2qiao22/RM_Main_Board_Teensy4.1/README.md

# RM_NAGOYA_Main_Control_Board

## Overview
A main control board for robot control in the RoboMaster competition.

## Specifications
- **MCU**: Teensy 4.1  
- **IMU**: BNO055  
- **CAN**: 3 channels  
 
- **Design Tool**: KiCad 9.0
