2qiao22/RM_Main_Board_Teensy4.1/3D/B3B-XH-A-LF--SN---3DModel-STEP-418109.STEP

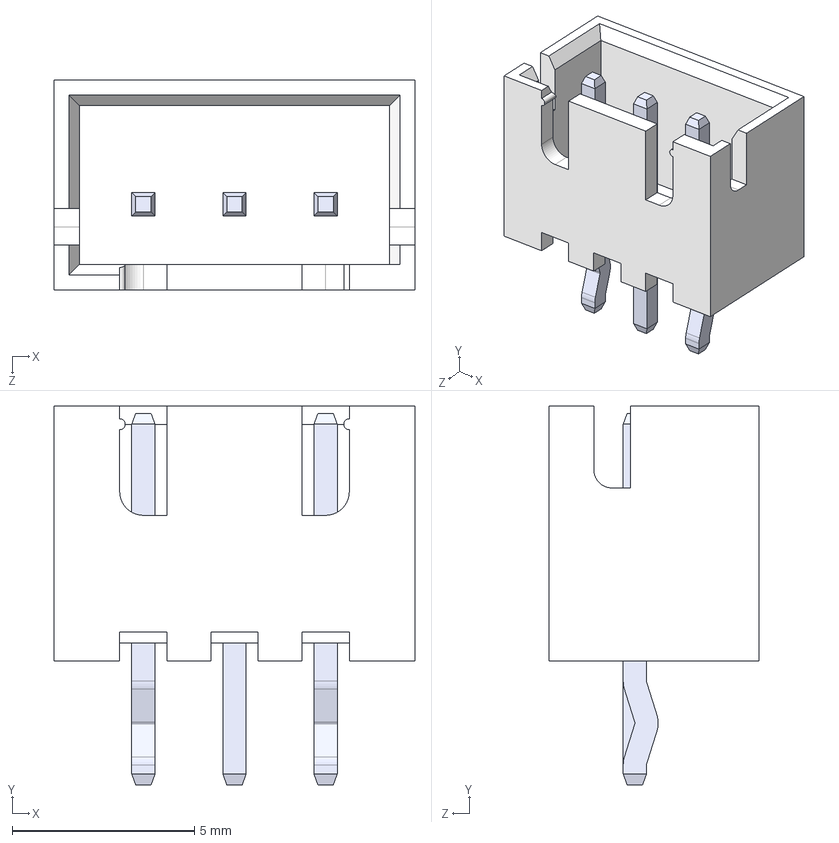
[picture p1: CAD file, 2025-04-14]
3D/B3B-XH-A-LF--SN---3DModel-STEP-418109.STEP
9.90 x 10.4 x 5.75 mm
