2qiao22/RM_Main_Board_Teensy4.1/3D/xb-pm2142-atx30u-f.stp

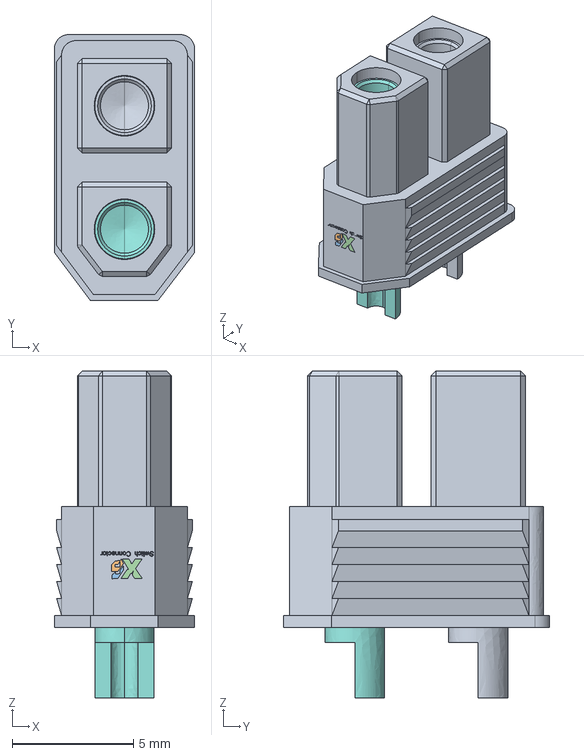
[picture p2: CAD file, 2025-04-14]
3D/xb-pm2142-atx30u-f.stp
5.80 x 11.0 x 13.5 mm
