2qiao22/RM_Main_Board_Teensy4.1/3D/XT30UPB-M--3DModel-STEP-510211.STEP

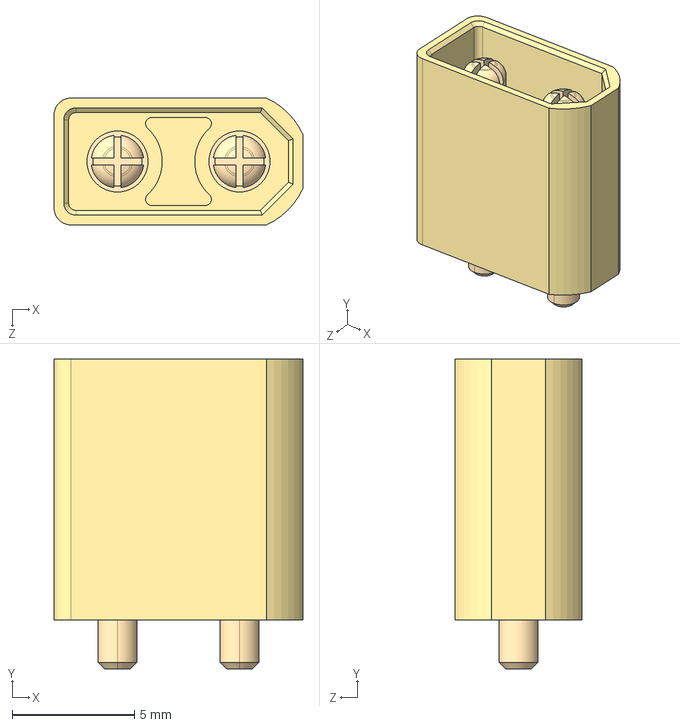
[picture p3: CAD file, 2025-04-14]
3D/XT30UPB-M--3DModel-STEP-510211.STEP
10.2 x 12.7 x 5.20 mm
