2qiao22/RM_Main_Board_Teensy4.1/3D/SIP3_M78AR-0_5_MIN.step

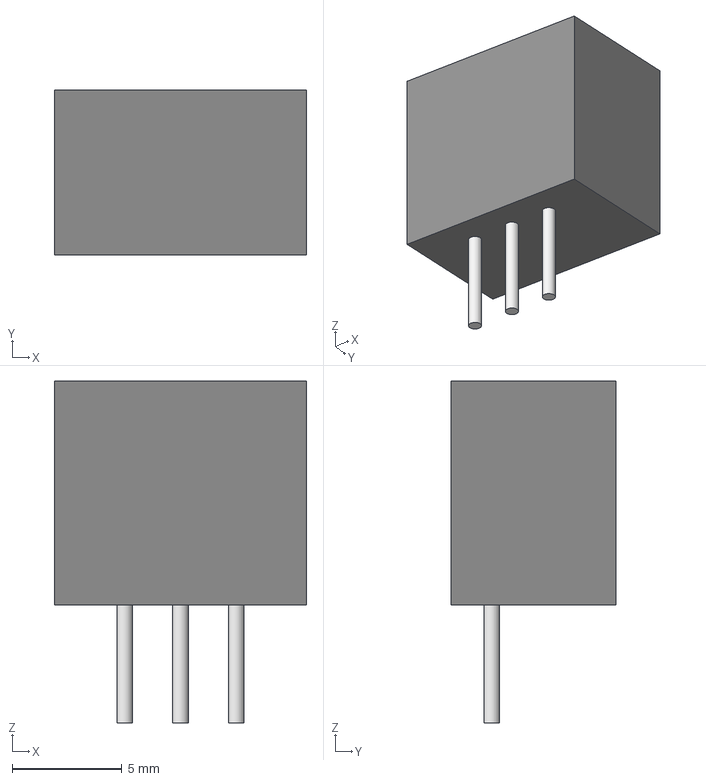
[picture p4: CAD file, 2025-04-14]
3D/SIP3_M78AR-0_5_MIN.step
11.5 x 7.54 x 15.6 mm
