2qiao22/RM_Main_Board_Teensy4.1/3D/10118194-0001LF--3DModel-STEP-269445.STEP

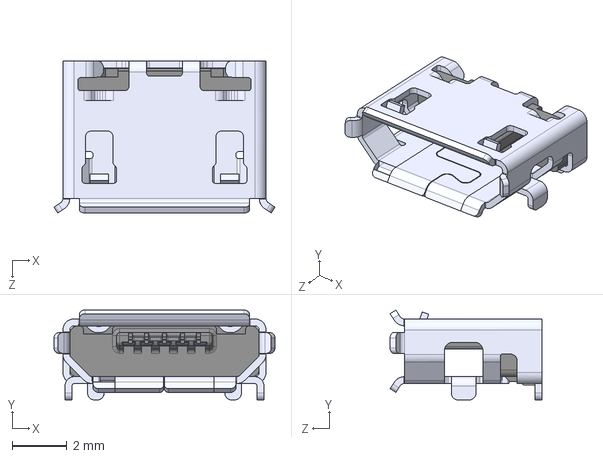
[picture p5: CAD file, 2025-04-14]
3D/10118194-0001LF--3DModel-STEP-269445.STEP
8.05 x 3.27 x 5.53 mm
