2qiao22/RM_Main_Board_Teensy4.1/NAGOYA_Normal_Board.pdf

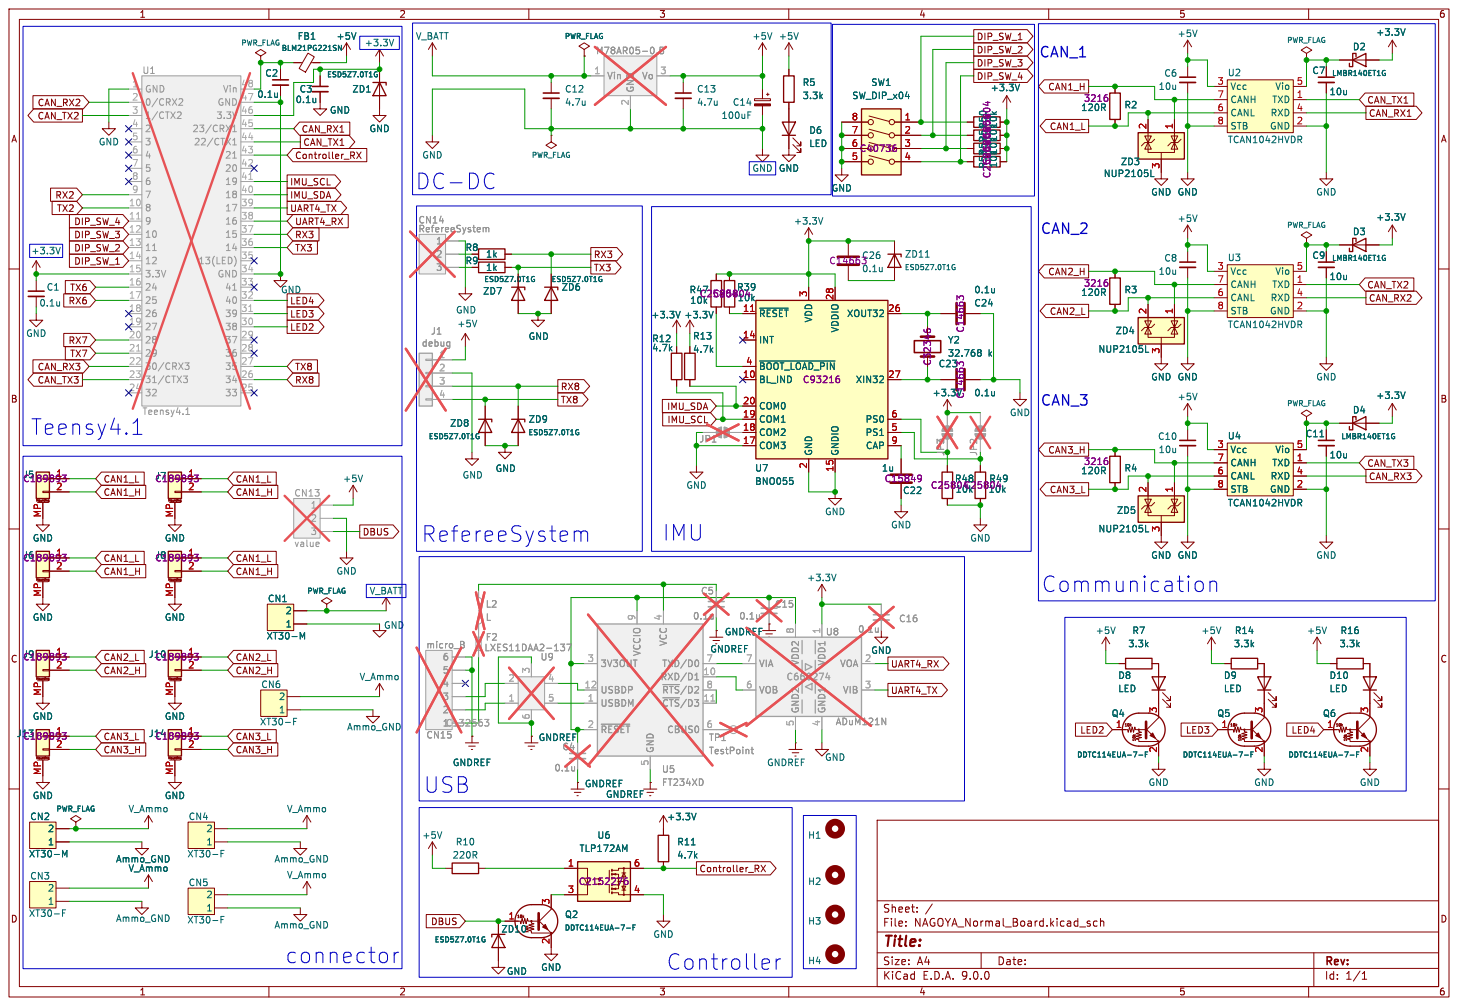
[picture p6: page 1]

Vio 5 TXD 1 RXD 4 GND 2 Vcc 3 CANH 7 CANL 6 STB 8 U2 TCAN1042HVDR

Vio 5 TXD 1 RXD 4 GND 2 Vcc 3 CANH 7 CANL 6 STB 8 U4 TCAN1042HVDR

4 TXD/D0 7 RXD/D1 10 ~{RTS}/D28 ~{CTS}/D311 CBUS0 6 U5 FT234XD GNDREF C16

4 TXD/D0 7 RXD/D1 10 ~{RTS}/D28 ~{CTS}/D311 CBUS0 6 GNDREF C16

Id: 1/1 Title: File: NAGOYA_Normal_Board.kicad_sch Sheet: /
