2qiao22/RM_Main_Board_Teensy4.1/NAGOYA_Normal_Board.kicad_pcb

## KiCad design NAGOYA_Normal_Board.kicad_pcb (2025-04-14)

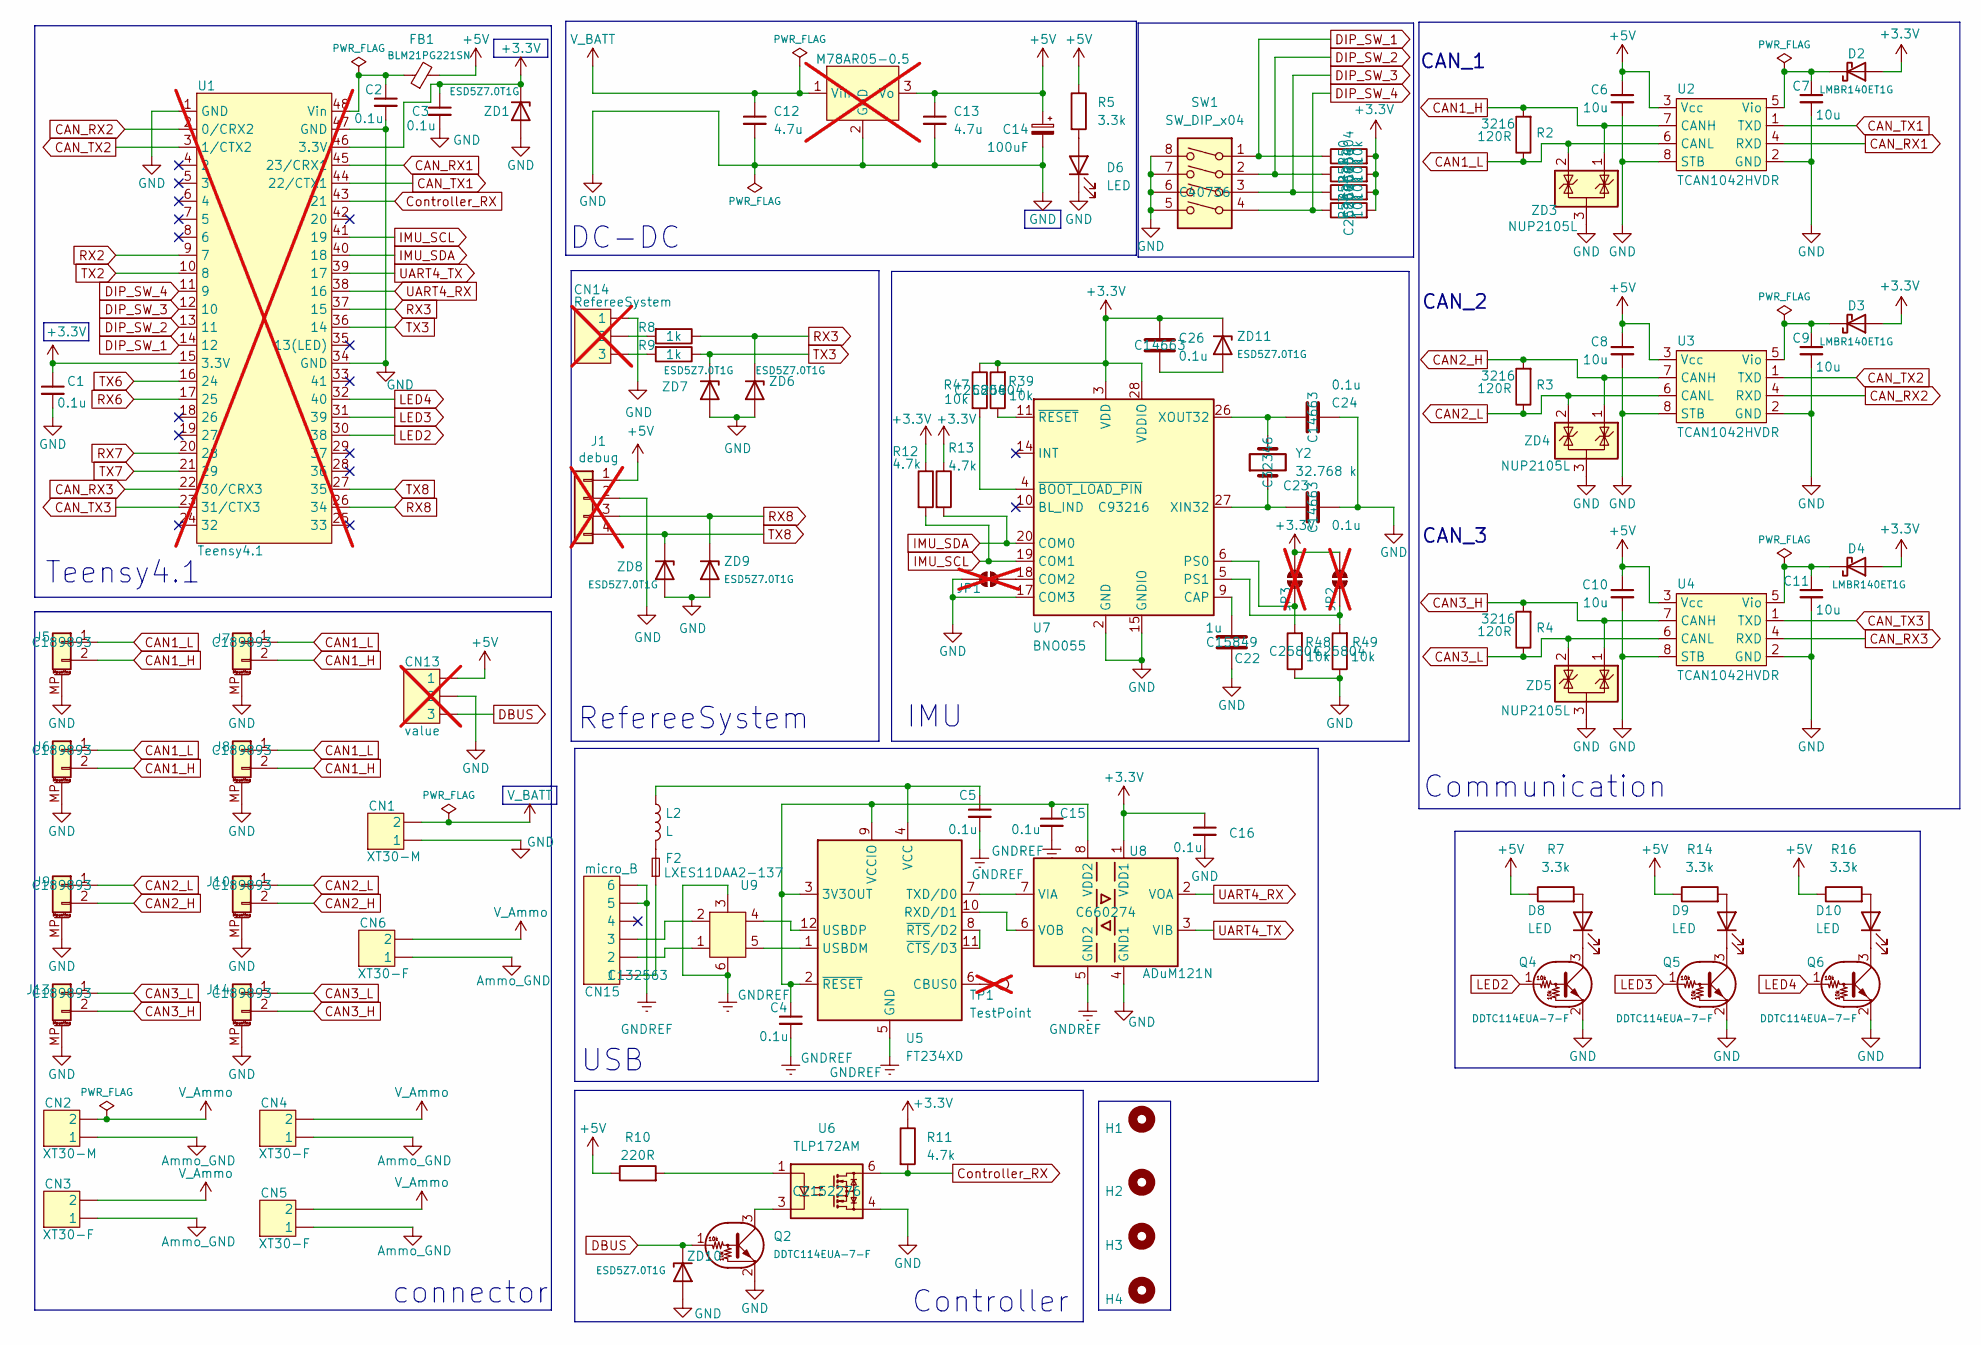
[picture p7: schematic NAGOYA_Normal_Board.kicad_sch]

Parts:
C1, C2, C3, C4, C5, C15, C16, C23, C24, C26: 0.1u; C_0603_1608Metric; LCSC C14663
C6, C7, C8, C9, C10, C11: 10u; C_1206_3216Metric; LCSC C13585
C12, C13: 4.7u; C_1206_3216Metric; LCSC C29823
C14: 100uF; CP_Elec_6.3x7.7; LCSC C3338
C22: 1u; C_0603_1608Metric; LCSC C15849
CN1, CN2: XT30-M; AMASS_XT30U-M_1x02_P5.0mm_Vertical; LCSC C428721
CN3, CN4, CN5, CN6: XT30-F; AMASS_XT30U-F_1x02_P5.0mm_Vertical; LCSC C108769
CN13: value; PinHeader_1x03_P2.54mm_Vertical; not fitted
CN14: RefereeSystem; JST_XH_B3B-XH-AM_1x03_P2.50mm_Vertical; not fitted
CN15: micro_B; USB_Micro-B_Amphenol_10118194-0001LF_Horizontal; LCSC C132563
D2, D3, D4: LMBR140ET1G; D_TUMD2; LCSC C172430
D6, D8, D9, D10: LED; LED_0603_1608Metric; LCSC C510027
F2: Fuse_Small; Fuse_0603_1608Metric; LCSC C116602
FB1: BLM21PG221SN; R_0805_2012Metric; LCSC C85840
H1, H2, H3, H4: MountingHole; MountingHole_3.2mm_M3_ISO14580
J1: debug; JST_XH_B4B-XH-A_1x04_P2.50mm_Vertical; LCSC C722867; not fitted
J5, J6, J7, J8, J9, J10, J13, J14: CAN3; JST_GH_SM02B-GHS-TB_1x02-1MP_P1.25mm_Horizontal; LCSC C189893
JP1, JP2, JP3: SolderJumper_2_Open; SolderJumper-2_P1.3mm_Open_TrianglePad1.0x1.5mm; not fitted
L2: L; L_0603_1608Metric; LCSC C85834
M78AR05-0.5: SIP3_LMS78-12_GAP; not fitted
Q2, Q4, Q5, Q6: DDTC114EUA-7-F; SOT-323_SC-70; LCSC C177021
R2, R3, R4: 120R; R_1206_3216Metric; LCSC C17909
R5, R7, R14, R16: 3.3k; R_0603_1608Metric; LCSC C4109
R8, R9: 1k; R_0603_1608Metric; LCSC C21190
R10: 220R; R_0603_1608Metric; LCSC C22962
R11, R12, R13: 4.7k; R_0805_2012Metric; LCSC C17673
R39, R47, R48, R49, R50, R51, R52, R53: 10k; R_0603_1608Metric; LCSC C25804
SW1: SW_DIP_x04; SW_DIP_SPSTx04_Slide_Copal_CHS-04B_W7.62mm_P1.27mm; LCSC C40736
TP1: TestPoint; TestPoint_Pad_1.0x1.0mm; not fitted
U1: Teensy4.1; DIP-48_W15.24mm_Socket_LongPads; not fitted
U2, U3, U4: TCAN1042HVDR; SOIC-8_3.9x4.9mm_P1.27mm; LCSC C485807
U5: FT234XD; WDFN-12-1EP_3x3mm_P0.45mm_EP1.7x2.5mm
U6: TLP172AM; MFSOP6-4_4.4x3.6mm_P1.27mm; LCSC C2152276
U7: BNO055; LGA-28_5.2x3.8mm_P0.5mm; LCSC C93216
U8: ADuM121N; SOIC-8_3.9x4.9mm_P1.27mm; LCSC C660274
U9: LXES11DAA2-137; FIL_LXES11DAA2-137
Y2: 32.768 k; Crystal_SMD_3215-2Pin_3.2x1.5mm; LCSC C32346
ZD1, ZD6, ZD7, ZD8, ZD9, ZD10, ZD11: ESD5Z7.0T1G; D_SOD-523; LCSC C133093
ZD3, ZD4, ZD5: NUP2105L; SOT-23; LCSC C14486

Connections:
+3.3V: C1.1, C3.1, C16.1, C26.1, D2.2 (A), D3.2 (A), D4.2 (A), JP2.1 (A), JP3.1 (A), R11.1, R12.1, R13.1, R39.2, R47.1, R50.2, R51.2, R52.2, R53.2, U1.15 (3.3V), U1.46 (3.3V), U7.3 (VDD), U7.28 (VDDIO), U8.1 (VDD1), ZD1.1 (K), ZD11.1 (K)
+5V: C6.1, C8.1, C10.1, C13.1, C14.1, CN13.1, FB1.2, J1.1, M78AR05-0.5.3 (Vo), R5.1, R7.1, R10.1, R14.1, R16.1, U2.3 (Vcc), U3.3 (Vcc), U4.3 (Vcc)
Ammo_GND: CN2.1, CN3.1, CN4.1, CN5.1, CN6.1
CAN1_H: J5.2, J6.2, J7.2, J8.2, R2.2, U2.7 (CANH), ZD3.1 (K)
CAN1_L: J5.1, J6.1, J7.1, J8.1, R2.1, U2.6 (CANL), ZD3.2 (K)
CAN2_H: J9.2, J10.2, R3.2, U3.7 (CANH), ZD4.1 (K)
CAN2_L: J9.1, J10.1, R3.1, U3.6 (CANL), ZD4.2 (K)
CAN3_H: J13.2, J14.2, R4.2, U4.7 (CANH), ZD5.1 (K)
CAN3_L: J13.1, J14.1, R4.1, U4.6 (CANL), ZD5.2 (K)
CAN_RX1: U1.45 (23/CRX1), U2.4 (RXD)
CAN_RX2: U1.2 (0/CRX2), U3.4 (RXD)
CAN_RX3: U1.22 (30/CRX3), U4.4 (RXD)
CAN_TX1: U1.44 (22/CTX1), U2.1 (TXD)
CAN_TX2: U1.3 (1/CTX2), U3.1 (TXD)
CAN_TX3: U1.23 (31/CTX3), U4.1 (TXD)
Controller_RX: R11.2, U1.43 (21), U6.6
DBUS: CN13.3, Q2.1 (B), ZD10.1 (K)
DIP_SW_1: R50.1, SW1.1, U1.14 (12)
DIP_SW_2: R51.1, SW1.2, U1.13 (11)
DIP_SW_3: R52.1, SW1.3, U1.12 (10)
DIP_SW_4: R53.1, SW1.4, U1.11 (9)
GND: C1.2, C2.2, C3.2, C6.2, C7.2, C8.2, C9.2, C10.2, C11.2, C12.2, C13.2, C14.2, C16.2, C22.2, C23.1, C24.1, CN1.1, CN13.2, CN14.1, D6.1 (K), J1.2, J5.MP (MountPin), J6.MP (MountPin), J7.MP (MountPin), J8.MP (MountPin), J9.MP (MountPin), J10.MP (MountPin), J13.MP (MountPin), J14.MP (MountPin), JP1.2 (B), M78AR05-0.5.2 (GND), Q2.2 (E), Q4.2 (E), Q5.2 (E), Q6.2 (E), R48.1, R49.1, SW1.5, SW1.6, SW1.7, SW1.8, U1.1 (GND), U1.34 (GND), U1.47 (GND), U2.2 (GND), U2.8 (STB), U3.2 (GND), U3.8 (STB), U4.2 (GND), U4.8 (STB), U6.4, U7.2 (GND), U7.15 (GNDIO), U7.16 (GNDIO), U7.17 (COM3), U7.25 (GNDIO), U8.4 (GND1), ZD1.2 (A), ZD3.3 (A), ZD4.3 (A), ZD5.3 (A), ZD6.2 (A), ZD7.2 (A), ZD8.2 (A), ZD9.2 (A), ZD10.2 (A)
GNDREF: C4.2, C5.2, C15.2, CN15.5, CN15.6, U5.5 (GND), U5.13 (GND), U8.5 (GND2), U9.3, U9.6
IMU_SCL: R12.2, U1.41 (19), U7.19 (COM1)
IMU_SDA: R13.2, U1.40 (18), U7.20 (COM0)
LED2: Q4.1 (B), U1.30 (38)
LED3: Q5.1 (B), U1.31 (39)
LED4: Q6.1 (B), U1.32 (40)
unnamed: CN14.2, R8.2
unnamed: CN14.3, R9.2
unnamed: CN15.1, F2.1
unnamed: CN15.2, U9.1
unnamed: CN15.3, U9.2
unnamed: C7.1, D2.1 (K), U2.5 (Vio)
unnamed: C9.1, D3.1 (K), U3.5 (Vio)
unnamed: C11.1, D4.1 (K), U4.5 (Vio)
unnamed: D6.2 (A), R5.2
unnamed: D8.2 (A), R7.2
unnamed: D8.1 (K), Q4.3 (C)
unnamed: D9.2 (A), R14.2
unnamed: D9.1 (K), Q5.3 (C)
unnamed: D10.2 (A), R16.2
unnamed: D10.1 (K), Q6.3 (C)
unnamed: F2.2, L2.2
unnamed: JP1.1 (A), U7.18 (COM2)
unnamed: JP2.2 (B), R49.2, U7.5 (PS1)
unnamed: JP3.2 (B), R48.2, U7.6 (PS0)
unnamed: Q2.3 (C), U6.3
unnamed: R10.2, U6.1
unnamed: C2.1, FB1.1, U1.48 (Vin)
unnamed: C4.1, C15.1, U5.2 (~RESET), U5.3 (3V3OUT), U5.9 (VCCIO), U8.8 (VDD2)
unnamed: TP1.1, U5.6 (CBUS0)
unnamed: U5.10 (RXD/D1), U8.6 (VOB)
unnamed: U5.7 (TXD/D0), U8.7 (VIA)
unnamed: U5.1 (USBDM), U9.5
unnamed: U5.12 (USBDP), U9.4
unnamed: C5.1, L2.1, U5.4 (VCC)
unnamed: U5.8 (~RTS/D2), U5.11 (~CTS/D3)
unnamed: C22.1, U7.9 (CAP)
unnamed: C23.2, U7.27 (XIN32), Y2.1
unnamed: C24.2, U7.26 (XOUT32), Y2.2
unnamed: R47.2, U7.4 (~BOOT_LOAD_PIN)
unnamed: R39.1, U7.11 (~RESET)
unnamed: C26.2, ZD11.2 (A)
RX2: U1.9 (7)
RX3: R8.1, U1.37 (15), ZD6.1 (K)
RX6: U1.17 (25)
RX7: U1.20 (28)
RX8: J1.3, U1.26 (34), ZD9.1 (K)
TX2: U1.10 (8)
TX3: R9.1, U1.36 (14), ZD7.1 (K)
TX6: U1.16 (24)
TX7: U1.21 (29)
TX8: J1.4, U1.27 (35), ZD8.1 (K)
UART4_RX: U1.38 (16), U8.2 (VOA)
UART4_TX: U1.39 (17), U8.3 (VIB)
V_Ammo: CN2.2, CN3.2, CN4.2, CN5.2, CN6.2
V_BATT: C12.1, CN1.2, M78AR05-0.5.1 (Vin)

Notes on the sheet:
Controller
connector
IMU
CAN_1
Teensy4.1
DC-DC
CAN_3
USB
CAN_2
RefereeSystem
Communication

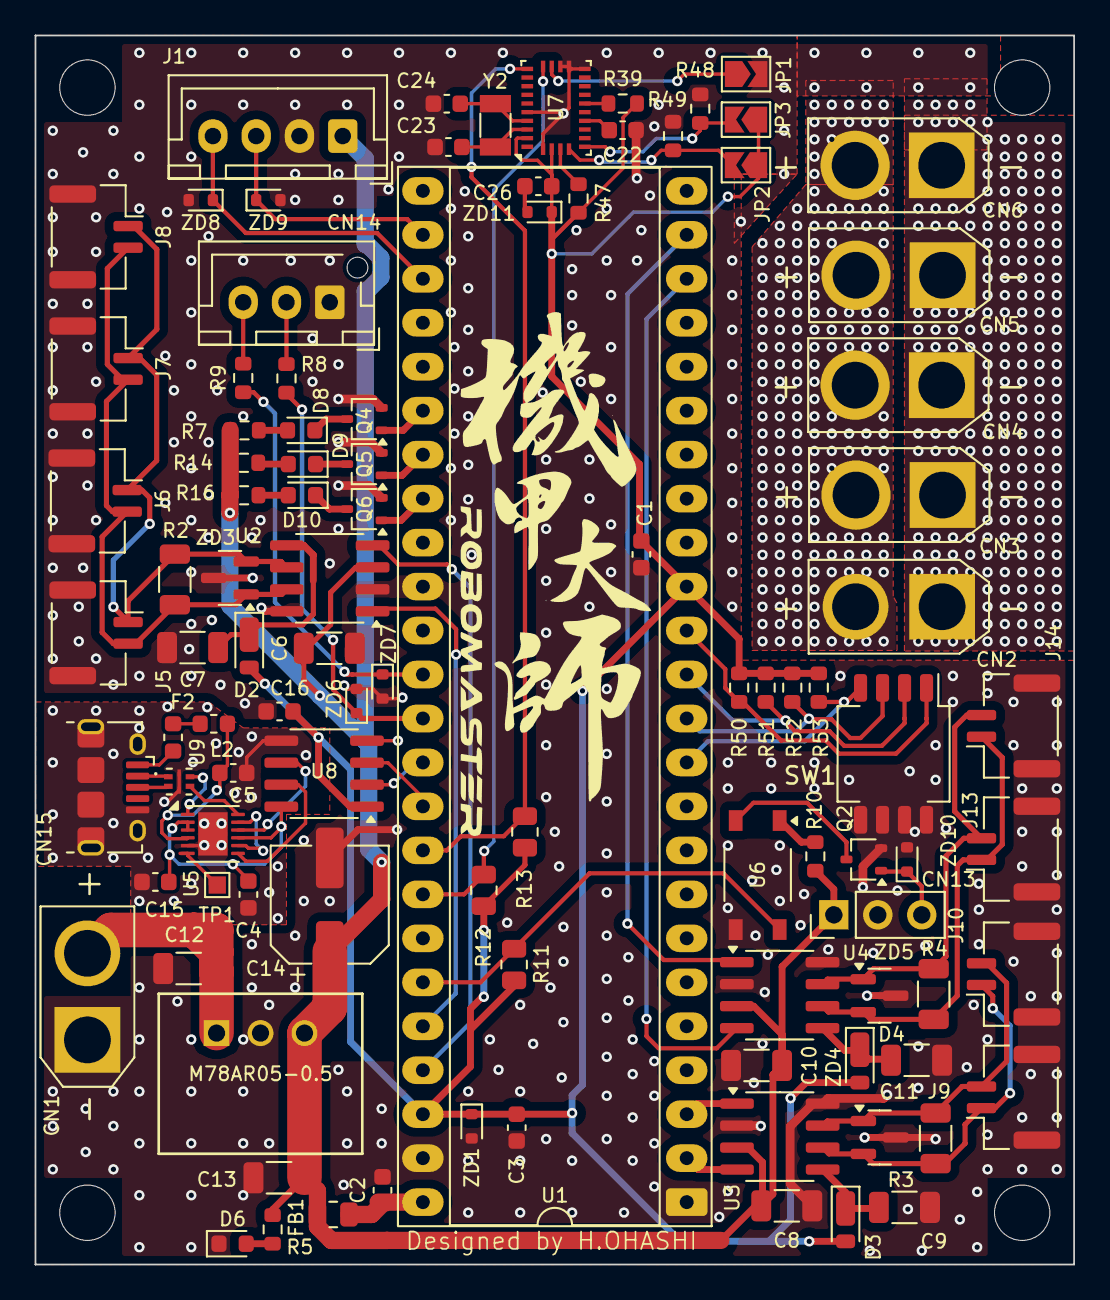
[picture p8: board NAGOYA_Normal_Board.kicad_pcb from above]

Board: 2 copper layers, 60.0 x 71.0 mm, 103 parts (0 on the bottom side), 72 nets.
