2qiao22/RM_Main_Board_Teensy4.1/(commit log)

2025-03-18 RS485を追加
    [NAGOYA_Normal_Board.kicad_sch]
2025-03-18 DCDCを変更
    [NAGOYA_Normal_Board.kicad_sch]
2025-03-18 USBシリアル変換を追加
    [NAGOYA_Normal_Board.kicad_sch]
2025-03-18 USB シリアルを追加
2025-04-02 PCBを作成。また、回路図の修正（DCDC）
2025-04-04 USBシリアルを絶縁＞パターン変更
    [NAGOYA_Normal_Board.kicad_pcb, NAGOYA_Normal_Board.kicad_sch]
2025-04-06 USBシリアルを絶縁
    [NAGOYA_Normal_Board.kicad_pcb, NAGOYA_Normal_Board.kicad_sch]
2025-04-13 発注用データ
    [NAGOYA_Normal_Board.kicad_pcb, NAGOYA_Normal_Board.kicad_sch]
2025-04-13 発注用parameterを変更
    [NAGOYA_Normal_Board.kicad_pcb, NAGOYA_Normal_Board.kicad_sch, bom.csv, designators.csv, positions.csv]
2025-04-14 シルクを修正
    [NAGOYA_Normal_Board.kicad_pcb]
2025-04-14 回路図PDFを最新版に変更
2025-04-14 3Dモデルを割当
    [10118194-0001LF--3DModel-STEP-269445.STEP, B3B-XH-A-LF--SN---3DModel-STEP-418109.STEP, NAGOYA_Normal_Board.kicad_pcb, NAGOYA_Normal_Board.kicad_sch, SIP3_M78AR-0_5_MIN.step, XT30UPB-M--3DModel-STEP-510211.STEP, xb-pm2142-atx30u-f.stp]
